KamilWuu/Stefan/README.md

# Stefan

### minisumo robot
### test gita czy cos
## git na windowsie
vscode
