KamilWuu/Stefan/docs/tytulowa.tex

\begin{titlepage} %crea l'enviroment
\begin{figure}[t] %inserisce le figure
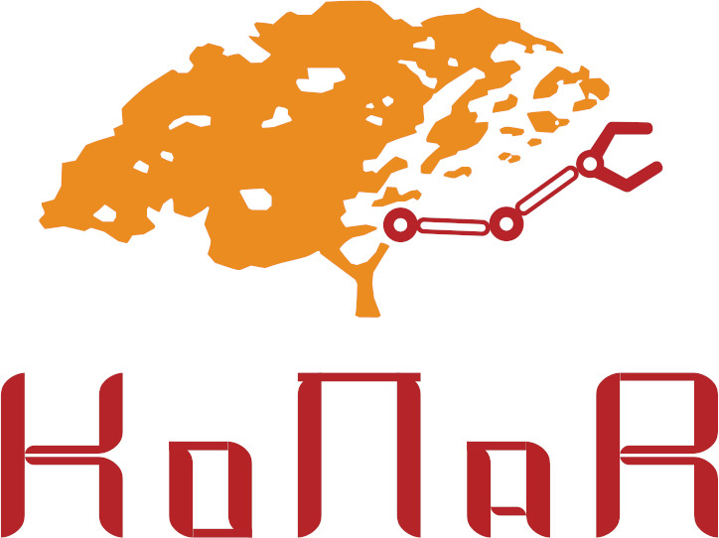
[picture p1: docs/photo_2/sprite_src_konar_vertical.jpg]
    \centering
\end{figure}
\vspace{20mm}

\begin{Large}
 \begin{center}
	\textbf{Koło naukowe robotyków KoNaR\\ Politechnika Wrocławska\\}
	\vspace{30mm}

            \hrule
            \vspace{10mm}
	{\huge{\bf Projekt robota mobilnego klasy minisumo "Stefan"}}
            \vspace{10mm}
            \hrule
\end{center}
\end{Large}

\vspace{36mm}
%minipage divide la pagina in due sezioni settabili
\begin{minipage}[t]{0.47\textwidth}
	
\end{minipage}
\hfill
\begin{minipage}[t]{0.47\textwidth}\raggedleft
	{\large{\bf Autor:\\ Kamil Winnicki}}
\end{minipage}

\vspace{25mm}

\hrulefill

\vspace{5mm}

\centering{\large{\bf Luty 2023 }}

\end{titlepage}
