KamilWuu/Stefan/docs/Opis robota ILYS_S.docx

1. Nazwa drużyny:

KoNaR_KW

2. Opis drużyny:

Jestem studentem 2 roku automatyki i robotyki na wydziale elektroniki, fotoniki i mikrosystemów na Politechnice Wrocławskiej. Od roku należe do koła naukowego robotyków KoNar.

3. Kamil należy do koła naukowego KoNaR z Politechniki Wrocławskiej. Jest ogromnym fanem robotyki. Robot klasy minisumo ILYT_S jest jego pierwszym robotem turniejowym.
4. Robot ILYT_S jest typowym robotem klasy minisumo. Napędzają go dwa silniki szczotkowe z przekładnią 1:30. Posiada aluminiową obudowę oraz konstrukcje wykonaną za pomocą technologii druku 3D. Strona elektroniczna opiera się na mikrokontrolerze Arduino NANO, sterowniku silników TB6612, dwóch odbiciowych czujników CNY70 wykorzystanych do detekcji koloru podłoża, oraz dwóch czujników odległości SHARP. Do zasilania została wykorzystana bateria Li – Pol 2S 7,4V oraz zastosowany został zewnętrzny stabilizator napięcia co jest dodatkowym zabezpieczniem przed przepaleniem stabilizatora wbudowanego do płytki Arduino. Program robota został napisany w środowisku Arduino. W najbliższym czasie planowana jest rozbudowa robota o „wachlarze” pozwalające na ciekawe taktyki walki. Robot ma szczegolną osobowość na co wskazuje jego niezwykły wyraz twarzy.

; )

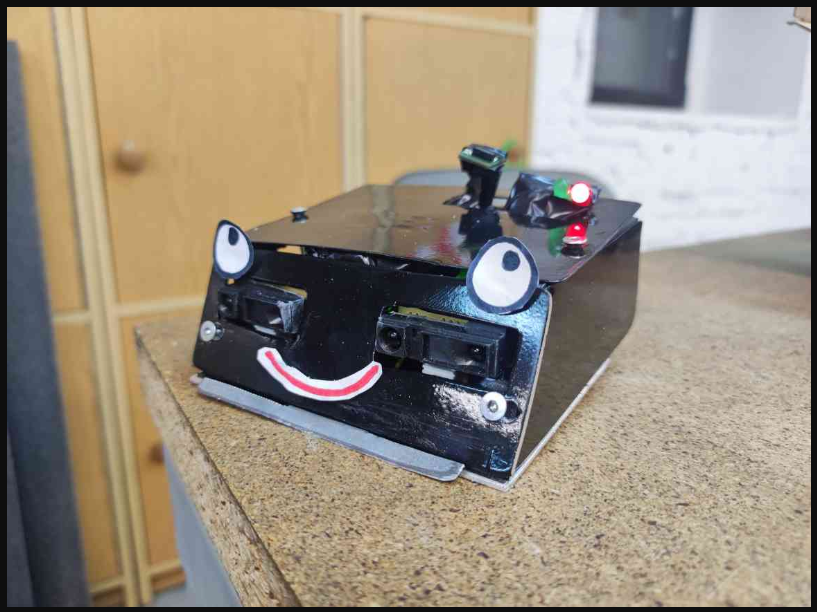
[picture p2: figure]
