KamilWuu/Stefan/docs/photo/Schemat_rozmieszczenia.jpg

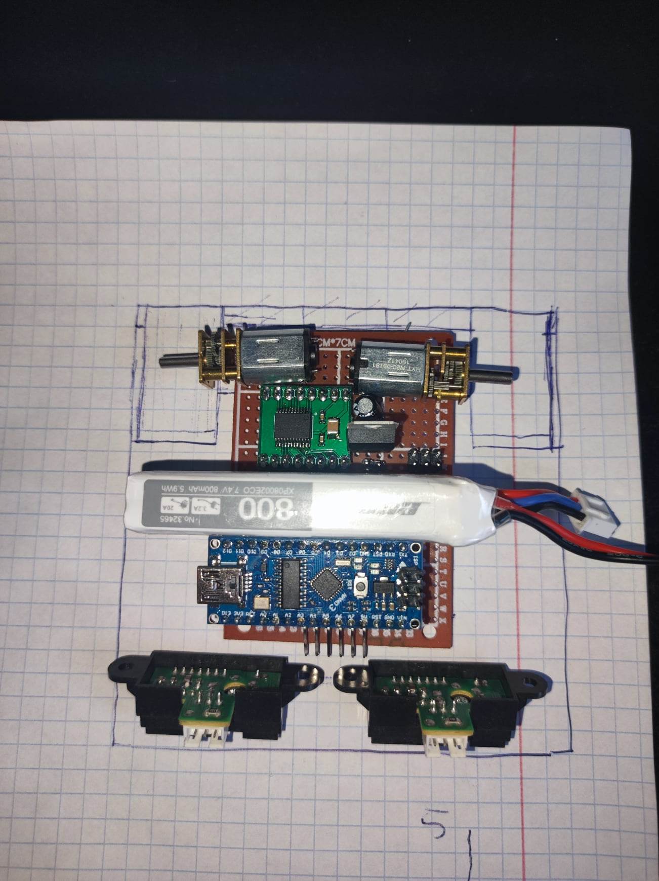
docs/photo/Schemat_rozmieszczenia.jpg
