KamilWuu/Stefan/docs/photo/Stabiliozator.jpg

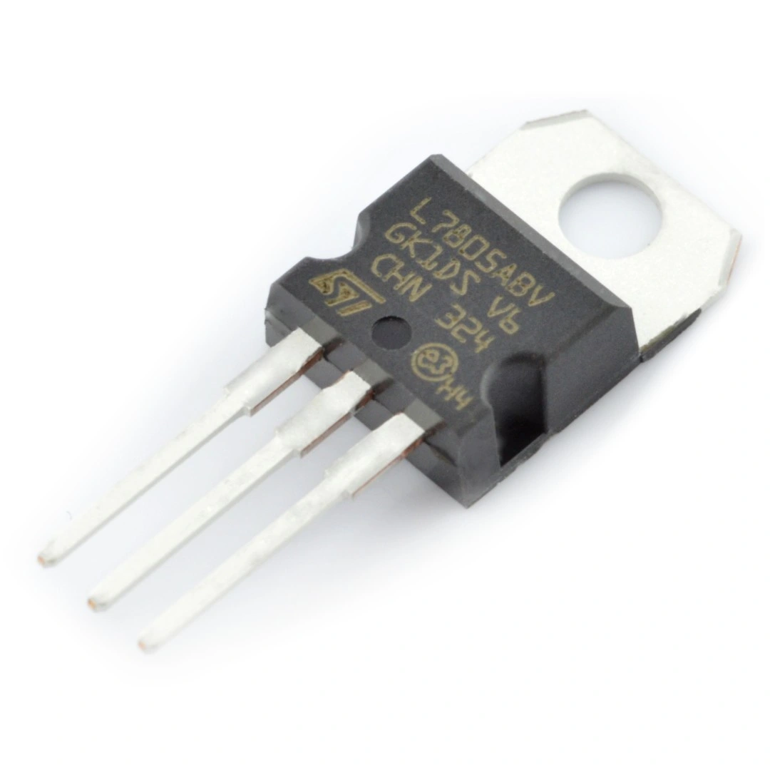
docs/photo/Stabiliozator.jpg
