KamilWuu/Stefan/docs/photo_2/330680536_1497188300806785_8608517706660153120_n.jpg

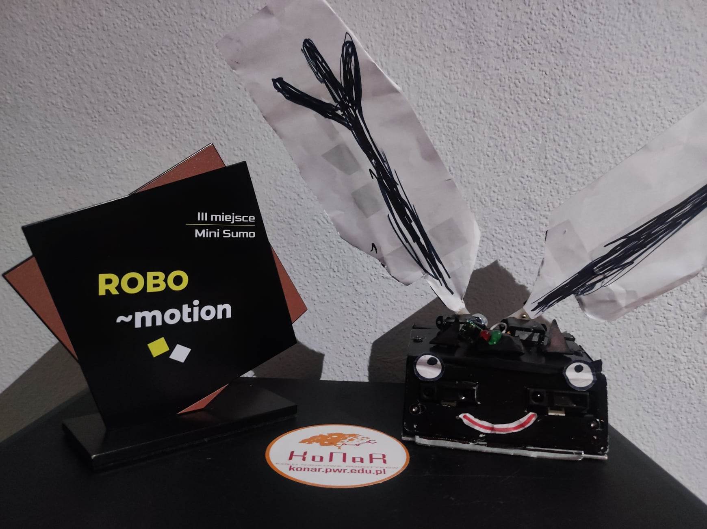
docs/photo_2/330680536_1497188300806785_8608517706660153120_n.jpg
