KamilWuu/Stefan/docs/photo_2/StefanBukareszt1.png

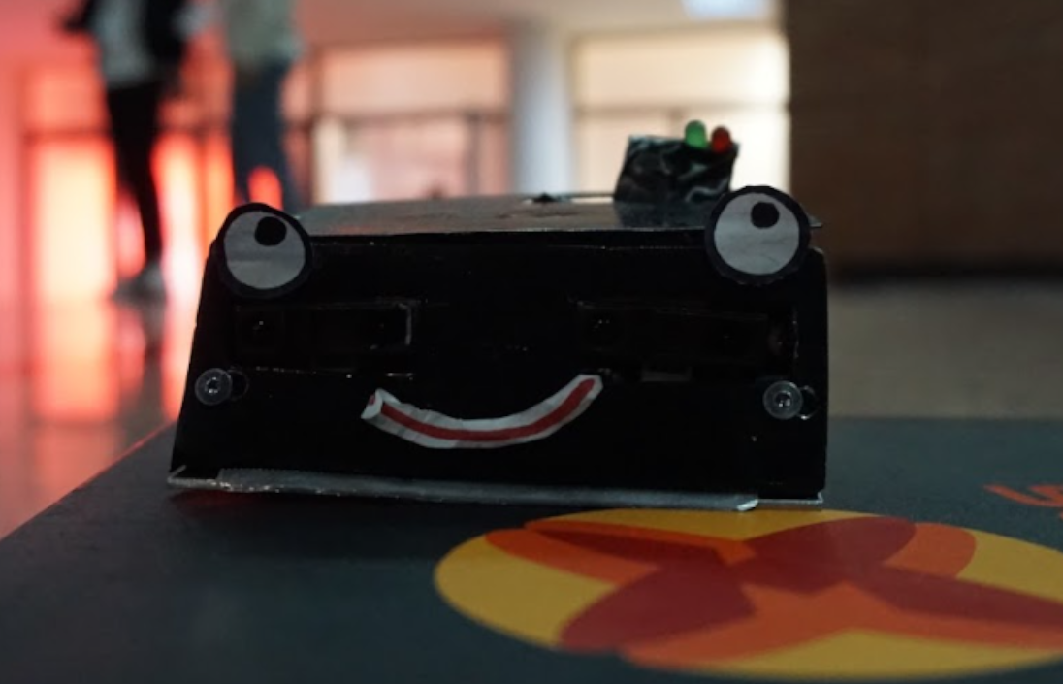
docs/photo_2/StefanBukareszt1.png
