KamilWuu/Stefan/docs/photo_2/Stefann.png

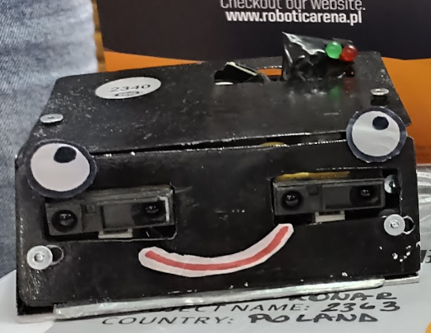
docs/photo_2/Stefann.png
