KamilWuu/Stefan/docs/photo_2/StefanZPolski.png

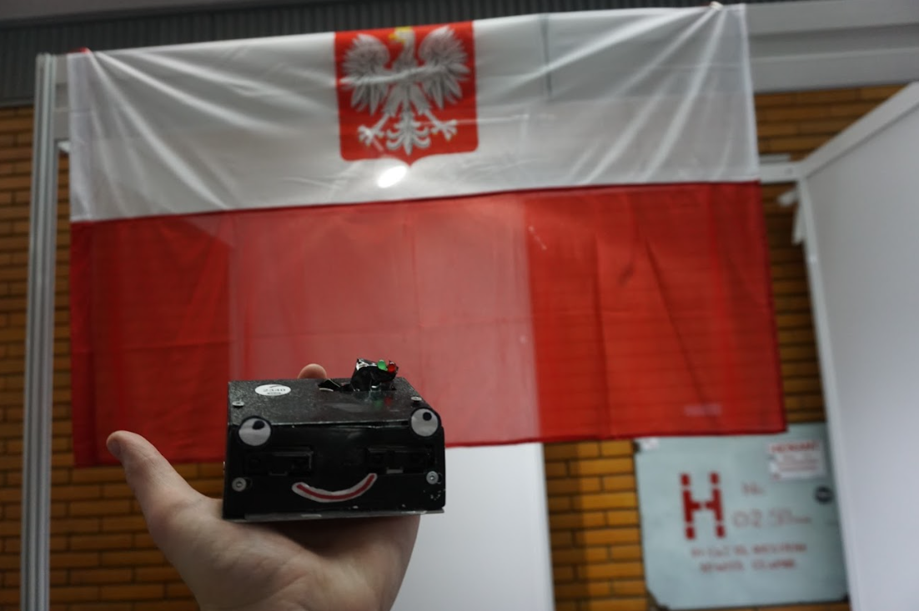
docs/photo_2/StefanZPolski.png
