KamilWuu/Stefan/docs/Scheme/caly.jpg

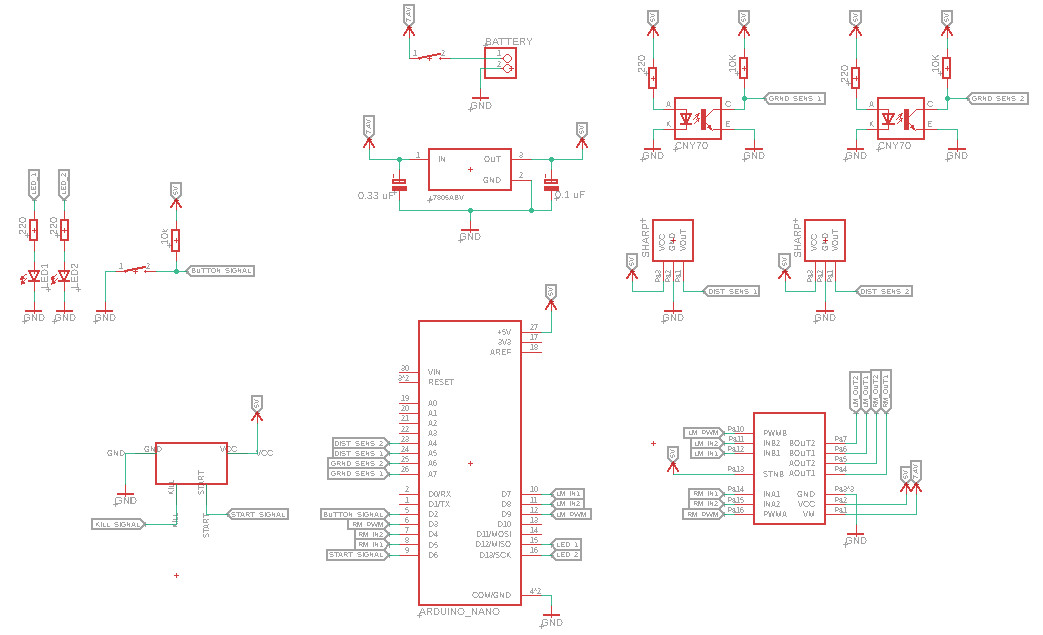
docs/Scheme/caly.jpg
