KamilWuu/Stefan/Zrzut ekranu 2023-07-08 150453.png

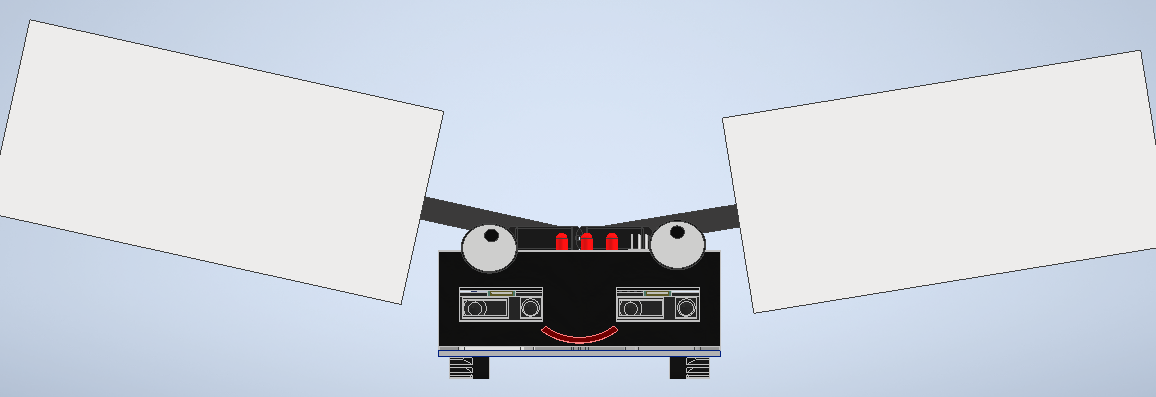
Zrzut ekranu 2023-07-08 150453.png
