KamilWuu/Stefan/mechanics_v2/dol.stl

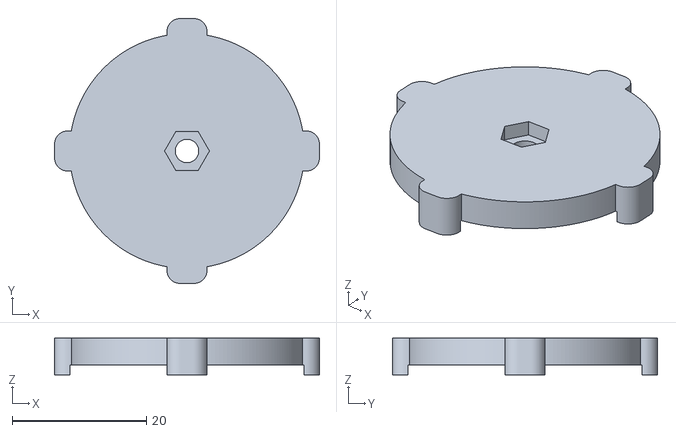
[picture p43: CAD file, 2024-05-01]
mechanics_v2/dol.stl
39.5 x 39.5 x 5.50
