KamilWuu/Stefan/mechanics_v2/board_up.stp

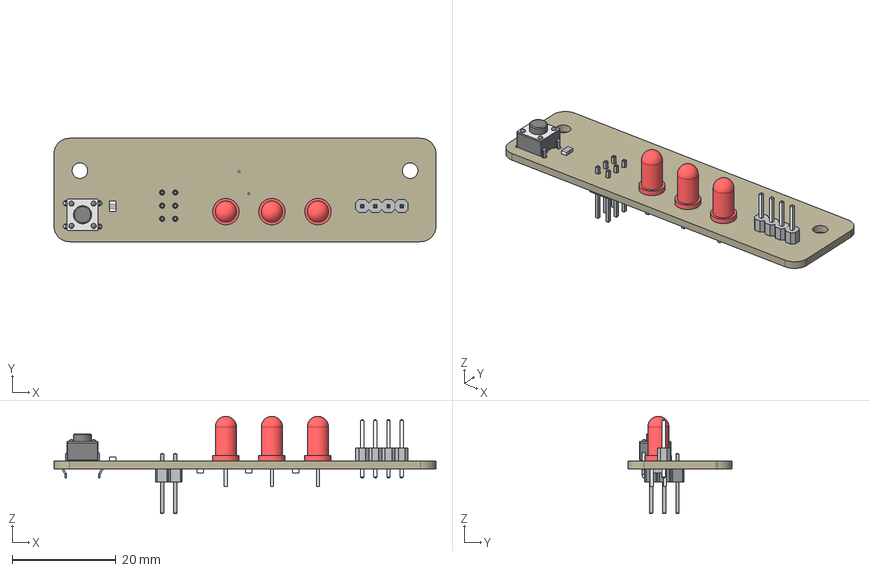
[picture p44: CAD file, 2023-07-09]
mechanics_v2/board_up.stp
73.8 x 20.0 x 18.8 mm
Board
LED5MM x 3
2X03
R0805 x 4
1X03 x 2
TS6-THT_H-5.0
