KamilWuu/Stefan/mechanics/uchwyt_na_silnik.stp

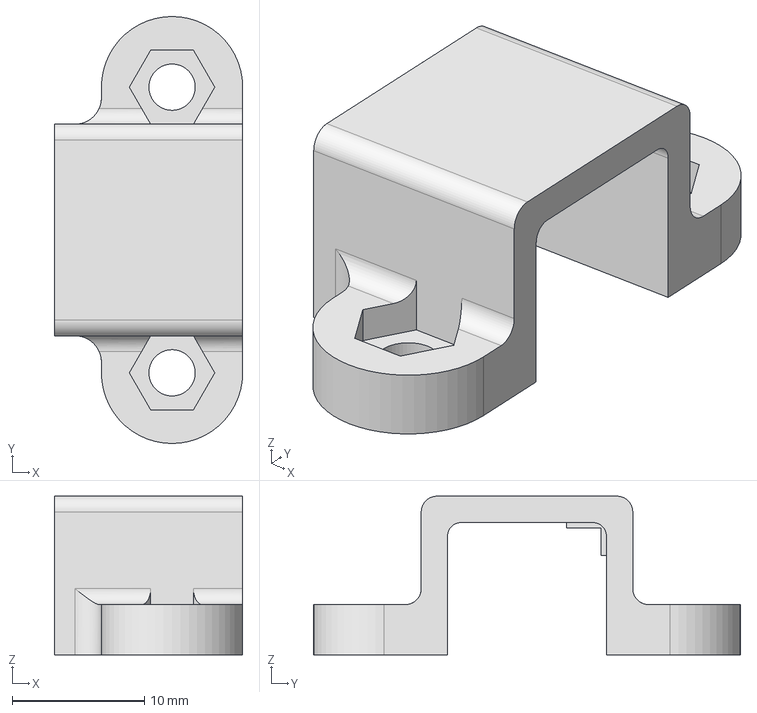
[picture p45: CAD file, 2023-05-13, an earlier design]
mechanics/uchwyt_na_silnik.stp
14.2 x 32.3 x 12.0 mm
