KamilWuu/Stefan/(list of files, cad)

Other CAD files:
mechanics/FORMA.iam
mechanics/KÓŁKO_STEFAN.ipt
mechanics/KÓŁKO_STEFAN_NOWE.ipt
mechanics/KÓŁKO_STEFAN_NOWE_DO_FORMY.ipt
mechanics/OldVersions/PCB.0005.ipt
mechanics/OldVersions/PCBE_2_2.0002.ipt
mechanics/OldVersions/PCB_DOLNE+GORNE.0002.ipt
mechanics/OldVersions/SCIANA_2.0.0002.ipt
mechanics/OldVersions/SCIANA_2.0_MIR.0004.ipt
mechanics/OldVersions/STEFAN_2.0.0007.iam
mechanics/OldVersions/STEFAN_PRE_2.0 — kopia.0010.iam
mechanics/OldVersions/Zespół1.0001.iam
mechanics/OldVersions/koło_minisumo.0001.ipt
mechanics/OldVersions/minisumopodsr.0005.ipt
mechanics/OldVersions/mocowanie_serw.0004.ipt
mechanics/OldVersions/n20 motor.0001.ipt
mechanics/OldVersions/pokrywa lewa.0002.ipt
mechanics/OldVersions/pokrywa prawa.0004.ipt
mechanics/OldVersions/pokrywa.0003.ipt
mechanics/OldVersions/pokrywka.0001.ipt
mechanics/OldVersions/pług_v2.0002.ipt
mechanics/OldVersions/sciana PRE 2.0.0006.ipt
mechanics/OldVersions/sciana PRE 2.0_MIR1.0001.ipt
mechanics/OldVersions/sciana_lewa_v5.0003.ipt
mechanics/OldVersions/sciana_prawa_v4.0008.ipt
mechanics/OldVersions/servo_stefan.0001.ipt
mechanics/OldVersions/uchwyt_na_silnik.0001.ipt
mechanics/OldVersions/uchwyt_nowy.0001.ipt
mechanics/OldVersions/zlozenie.0009.iam
mechanics/SCIANA_2.0.ipt
mechanics/SCIANA_2.0_MIR.ipt
mechanics/SCIANA_2.0_MIR_MIR.ipt
mechanics/STEFAN_2.0.iam
mechanics/STEFAN_PRE_2.0 — kopia.iam
mechanics/TOF_VLCOS.ipt
mechanics/Zespół1.iam
mechanics/bateria szczurza.ipt
mechanics/koło.ipt
mechanics/microservo SG90.ipt
mechanics/microservo SG90_MIR.ipt
mechanics/minisumopodsr.ipt
mechanics/mocowanie_serw.ipt
mechanics/opona_nowa.ipt
mechanics/pokrywa lewa.ipt
mechanics/pokrywa prawa.ipt
mechanics/pokrywa.ipt
mechanics/pokrywka.ipt
mechanics/pług.ipt
mechanics/pług_v2.ipt
mechanics/sciana PRE 2.0.ipt
mechanics/sciana PRE 2.0_MIR.ipt
mechanics/sciana PRE 2.0_MIR1.ipt
mechanics/sciana PRE 2.0_MIR2.ipt
mechanics/sciana_lewa_v4.ipt
mechanics/sciana_lewa_v5.ipt
mechanics/sciana_prawa_v4.ipt
mechanics/servo_stefan.ipt
mechanics/servo_stefan_MIR.ipt
mechanics/uchwyt_na_silnik.ipt
mechanics/uchwytlewy.ipt
mechanics/uchwytprawy.ipt
mechanics/zlozenie.iam
mechanics_v2/1X02.ipt
mechanics_v2/1X03.ipt
mechanics_v2/2X03.ipt
mechanics_v2/Board_1.ipt
mechanics_v2/Board_2.ipt
mechanics_v2/GP2Y0A41SK0F.ipt
mechanics_v2/LED5MM.ipt
mechanics_v2/OldVersions/1X02.0001.ipt
mechanics_v2/OldVersions/SCIANA_LEWA_NOWA_2.0002.ipt
mechanics_v2/OldVersions/SCIANA_PRAWA_NOWA_2.0001.ipt
mechanics_v2/OldVersions/STEFAN.0029.iam
mechanics_v2/OldVersions/dach.0007.ipt
mechanics_v2/OldVersions/dol.0001.ipt
mechanics_v2/OldVersions/gora.0002.ipt
mechanics_v2/OldVersions/kolo.0002.ipt
mechanics_v2/OldVersions/minisumopodsr.0006.ipt
mechanics_v2/OldVersions/mocowanie sharpow.0015.ipt
mechanics_v2/OldVersions/oko.0001.ipt
mechanics_v2/OldVersions/opona.0003.ipt
mechanics_v2/OldVersions/ploter_1.0001.iam
mechanics_v2/OldVersions/ploter_1_SUB.0001.ipt
mechanics_v2/OldVersions/plug_2.0010.ipt
mechanics_v2/OldVersions/plug_kopia.0004.ipt
mechanics_v2/OldVersions/plug_nowy.0003.ipt
mechanics_v2/OldVersions/plytka_dol.0001.iam
mechanics_v2/OldVersions/podstawa.0008.ipt
mechanics_v2/OldVersions/pokrywa lewa.0004.ipt
mechanics_v2/OldVersions/pokrywa prawa.0006.ipt
mechanics_v2/OldVersions/pokrywa tylna.0002.ipt
mechanics_v2/OldVersions/reka.0002.ipt
mechanics_v2/OldVersions/sciana_prawa_nowa.0011.ipt
mechanics_v2/OldVersions/sciana_prawa_nowa_MIR.0004.ipt
mechanics_v2/OldVersions/servo_mini_1370hd_cos.0001.ipt
mechanics_v2/OldVersions/tyl.0003.ipt
mechanics_v2/OldVersions/tylna.0003.ipt
mechanics_v2/OldVersions/uchwyt_nowy.0002.ipt
mechanics_v2/OldVersions/uchwyt_serw.0001.ipt
mechanics_v2/OldVersions/uchwyt_silnikow.0002.ipt
mechanics_v2/OldVersions/wlacznik_2.0001.ipt
mechanics_v2/OldVersions/zaslepka.0002.ipt
mechanics_v2/SCIANA_LEWA_NOWA_2.ipt
mechanics_v2/SCIANA_PRAWA_NOWA_2.ipt
mechanics_v2/STEFAN.iam
mechanics_v2/TO220V.ipt
mechanics_v2/Zespół4.iam
mechanics_v2/blokada.ipt
mechanics_v2/board_up.ipt
mechanics_v2/buzia.ipt
mechanics_v2/dach.ipt
mechanics_v2/dociazenie.ipt
mechanics_v2/dol.ipt
mechanics_v2/forma.iam
mechanics_v2/gora.ipt
mechanics_v2/jakas awaryjna.ipt
mechanics_v2/kolo.ipt
mechanics_v2/kopia_plug.ipt
mechanics_v2/koło_minisumo.ipt
mechanics_v2/mocowanie sharpow.ipt
mechanics_v2/motor drive module TB6612.ipt
mechanics_v2/n20 motor.ipt
mechanics_v2/oko.ipt
mechanics_v2/opona.ipt
mechanics_v2/ploter_1.iam
mechanics_v2/ploter_1_SUB.ipt
mechanics_v2/plug_2.ipt
mechanics_v2/plug_kopia.ipt
mechanics_v2/plug_nowy.ipt
mechanics_v2/plytka_dol.iam
mechanics_v2/podstawa.ipt
mechanics_v2/podstawa_formy.ipt
mechanics_v2/pokrywa lewa.ipt
mechanics_v2/pokrywa prawa.ipt
mechanics_v2/pokrywa tylna.ipt
mechanics_v2/reka.ipt
mechanics_v2/sciana_lewa_NOWA.ipt
mechanics_v2/sciana_prawa_nowa.ipt
mechanics_v2/sciana_prawa_nowa_MIR.ipt
mechanics_v2/servo_mini_1370hd_cos.ipt
mechanics_v2/szkic.ipt
mechanics_v2/testowa.ipt
mechanics_v2/tyl.ipt
mechanics_v2/tylna.ipt
mechanics_v2/uchwyt_nowy.ipt
mechanics_v2/uchwyt_serw.ipt
mechanics_v2/uchwyt_silnikow.ipt
mechanics_v2/wlacznik.ipt
mechanics_v2/wlacznik_2.ipt
mechanics_v2/zaslepka.ipt
