KamilWuu/Stefan/(list of files, drawings)

Other design files:
electronics/MINISUMO final.fzz
electronics/minisumo kopia.fzz
electronics/minisumo LLSR.fzz
electronics/minisumo v2.fzz
electronics/sensor board.fzz
