KamilWuu/Stefan/electronics_v2/Stefan 2.0.brd

## EAGLE design electronics_v2/Stefan 2.0.brd (2024-05-01)

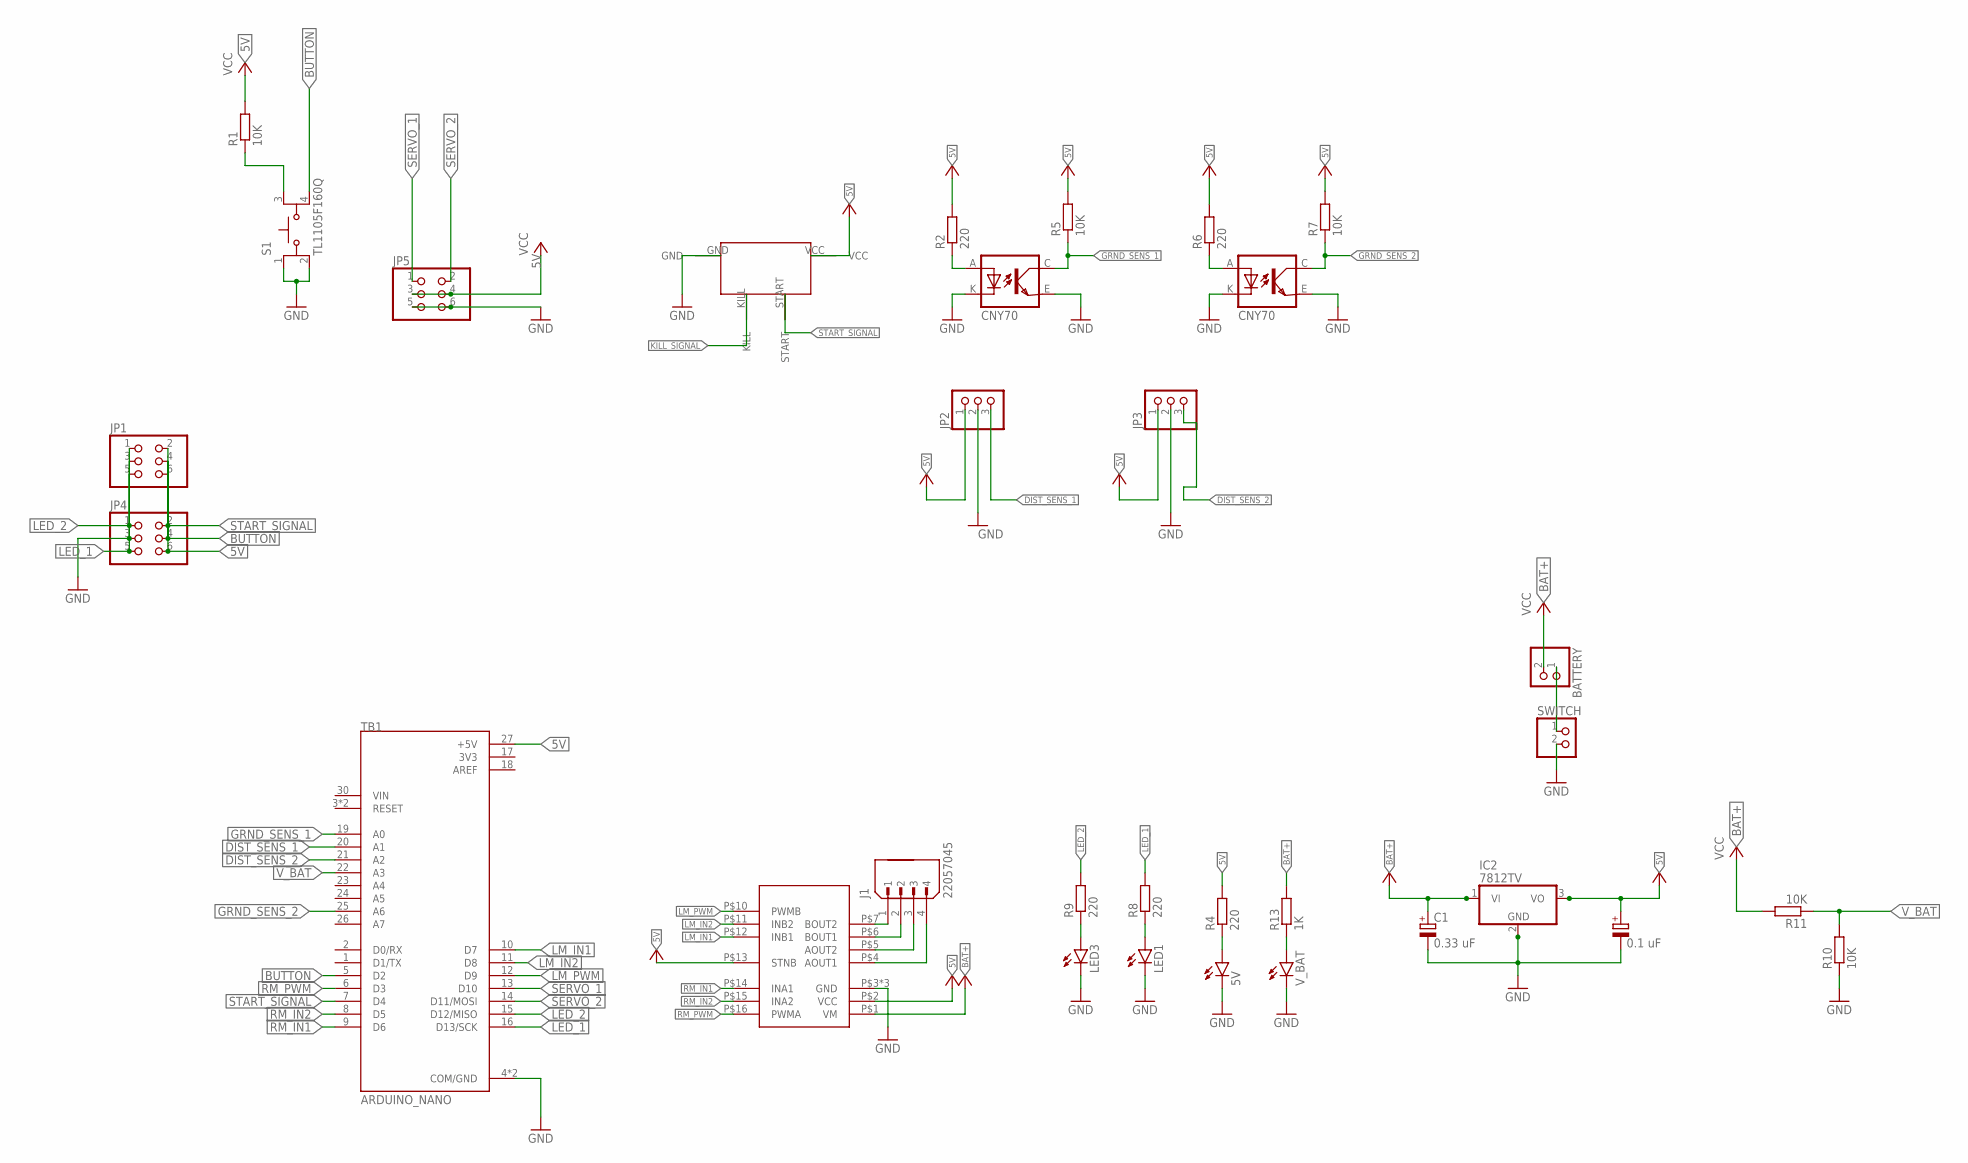
[picture p46: schematic Stefan 2.0.sch, sheet 1]

Parts:
5V: LED5MM
BATTERY: PINHD-1X2; 1X02
C1: 0.33 uF; TAP5-70
C2: 0.1 uF; SANYO-OSCON_A
IC2: 7812TV; TO220V
J1: 22057045; MOLEX_22057045
JP1, JP4, JP5: PINHD-2X3; 2X03
JP2, JP3: PINHD-1X3; 1X03
LED1, LED3: LED5MM
R1, R5, R7, R10, R11: 10K; R0805
R2, R4, R6, R8, R9: 220; R0805
R13: 1K; R0805
S1: TL1105F160Q; SW_TL1105F160Q
SUMO_START_MODULE1: SUMO_START_MODULE
SWITCH: PINHD-1X2; 1X02
TB1: ARDUINO_NANO; SHIELD_ARDUINO_NANO
TB2: TB6612MODULE
U$2, U$4: CNY70; 4
V_BAT: LEDCHIPLED_1206; CHIPLED_1206

Connections:
3V3: TB1.17 (3V3)
5V: C2.+, IC2.3 (VO), JP1.6, JP2.1, JP3.1, JP4.6, JP5.3, JP5.4, R1.2, R2.2, R4.2, R5.2, R6.2, R7.2, SUMO_START_MODULE1.VCC, TB1.27 (+5V), TB2.P$2 (VCC), TB2.P$13 (STNB)
AREF: TB1.18 (AREF)
BAT+: BATTERY.2, C1.+, IC2.1 (VI), R11.2, R13.2, TB2.P$1 (VM)
BUTTON: JP1.4, JP4.4, S1.4, TB1.5 (D2)
DIST_SENS_1: JP2.3, TB1.20 (A1)
DIST_SENS_2: JP3.3, TB1.21 (A2)
GND: 5V.K (C), C1.-, C2.-, IC2.2 (GND), JP1.3, JP2.2, JP3.2, JP4.3, JP5.5, JP5.6, LED1.K (C), LED3.K (C), R10.1, S1.1, S1.2, SUMO_START_MODULE1.GND, SWITCH.2, TB1.4 (COM/GND), TB1.29 (COM/GND), TB2.P$3 (GND), TB2.P$8 (GND), TB2.P$9 (GND), U$2.E (EMI), U$2.K (C), U$4.E (EMI), U$4.K (C), V_BAT.C
GRND_SENS_1: R5.1, TB1.19 (A0), U$2.C (COL)
GRND_SENS_2: R7.1, TB1.25 (A6), U$4.C (COL)
KILL_SIGNAL: SUMO_START_MODULE1.KILL
LED_1: JP1.5, JP4.5, R8.2, TB1.16 (D13/SCK)
LED_2: JP1.1, JP4.1, R9.2, TB1.15 (D12/MISO)
LM_IN1: TB1.10 (D7), TB2.P$12 (INB1)
LM_IN2: TB1.11 (D8), TB2.P$11 (INB2)
LM_OUT1: J1.2, TB2.P$6 (BOUT1)
LM_OUT2: J1.1, TB2.P$7 (BOUT2)
LM_PWM: TB1.12 (D9), TB2.P$10 (PWMB)
unnamed: BATTERY.1, SWITCH.1
unnamed: LED3.A, R9.1
unnamed: R2.1, U$2.A
unnamed: R6.1, U$4.A
unnamed: LED1.A, R8.1
unnamed: 5V.A, R4.1
unnamed: R13.1, V_BAT.A
unnamed: R1.1, S1.3
RM_IN1: TB1.9 (D6), TB2.P$14 (INA1)
RM_IN2: TB1.8 (D5), TB2.P$15 (INA2)
RM_OUT1: J1.4, TB2.P$4 (AOUT1)
RM_OUT2: J1.3, TB2.P$5 (AOUT2)
RM_PWM: TB1.6 (D3), TB2.P$16 (PWMA)
SERVO_1: JP5.1, TB1.13 (D10)
SERVO_2: JP5.2, TB1.14 (D11/MOSI)
START_SIGNAL: JP1.2, JP4.2, SUMO_START_MODULE1.START, TB1.7 (D4)
V_BAT: R10.2, R11.1, TB1.22 (A3)

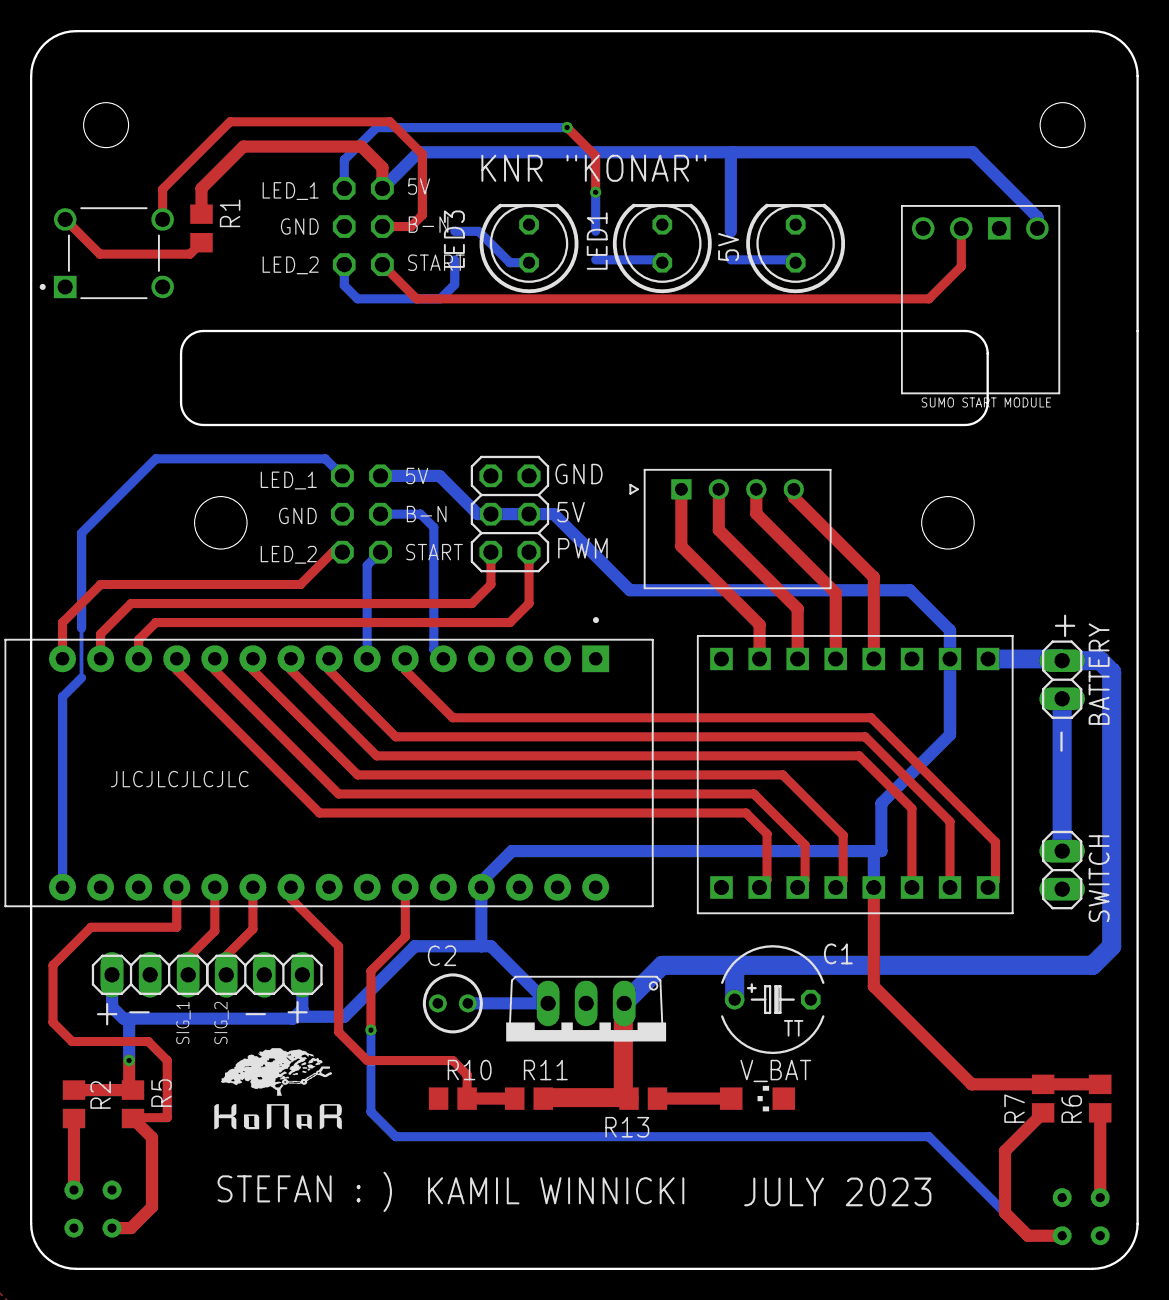
[picture p47: board Stefan 2.0.brd from above]

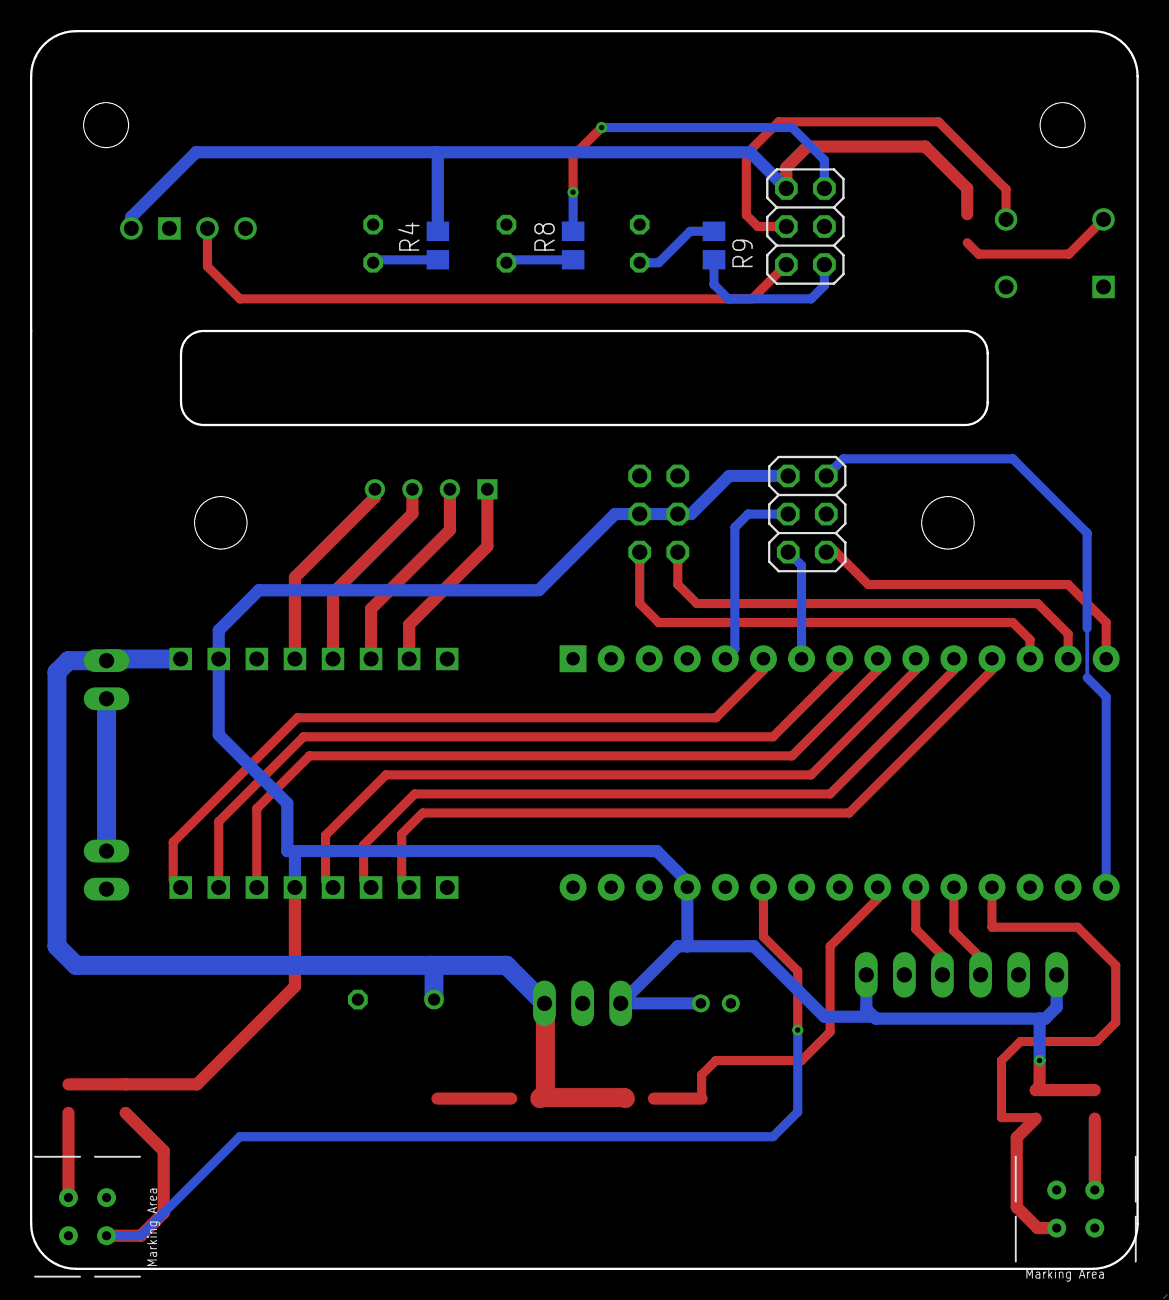
[picture p48: board Stefan 2.0.brd from below]

Board: 2 copper layers, 73.8 x 82.6 mm, 32 parts (7 on the bottom side), 32 nets.
