KamilWuu/Stefan/electronics/Stefan2/Stefan2.brd

## EAGLE design electronics/Stefan2/Stefan2.brd (2023-02-24, an earlier design)

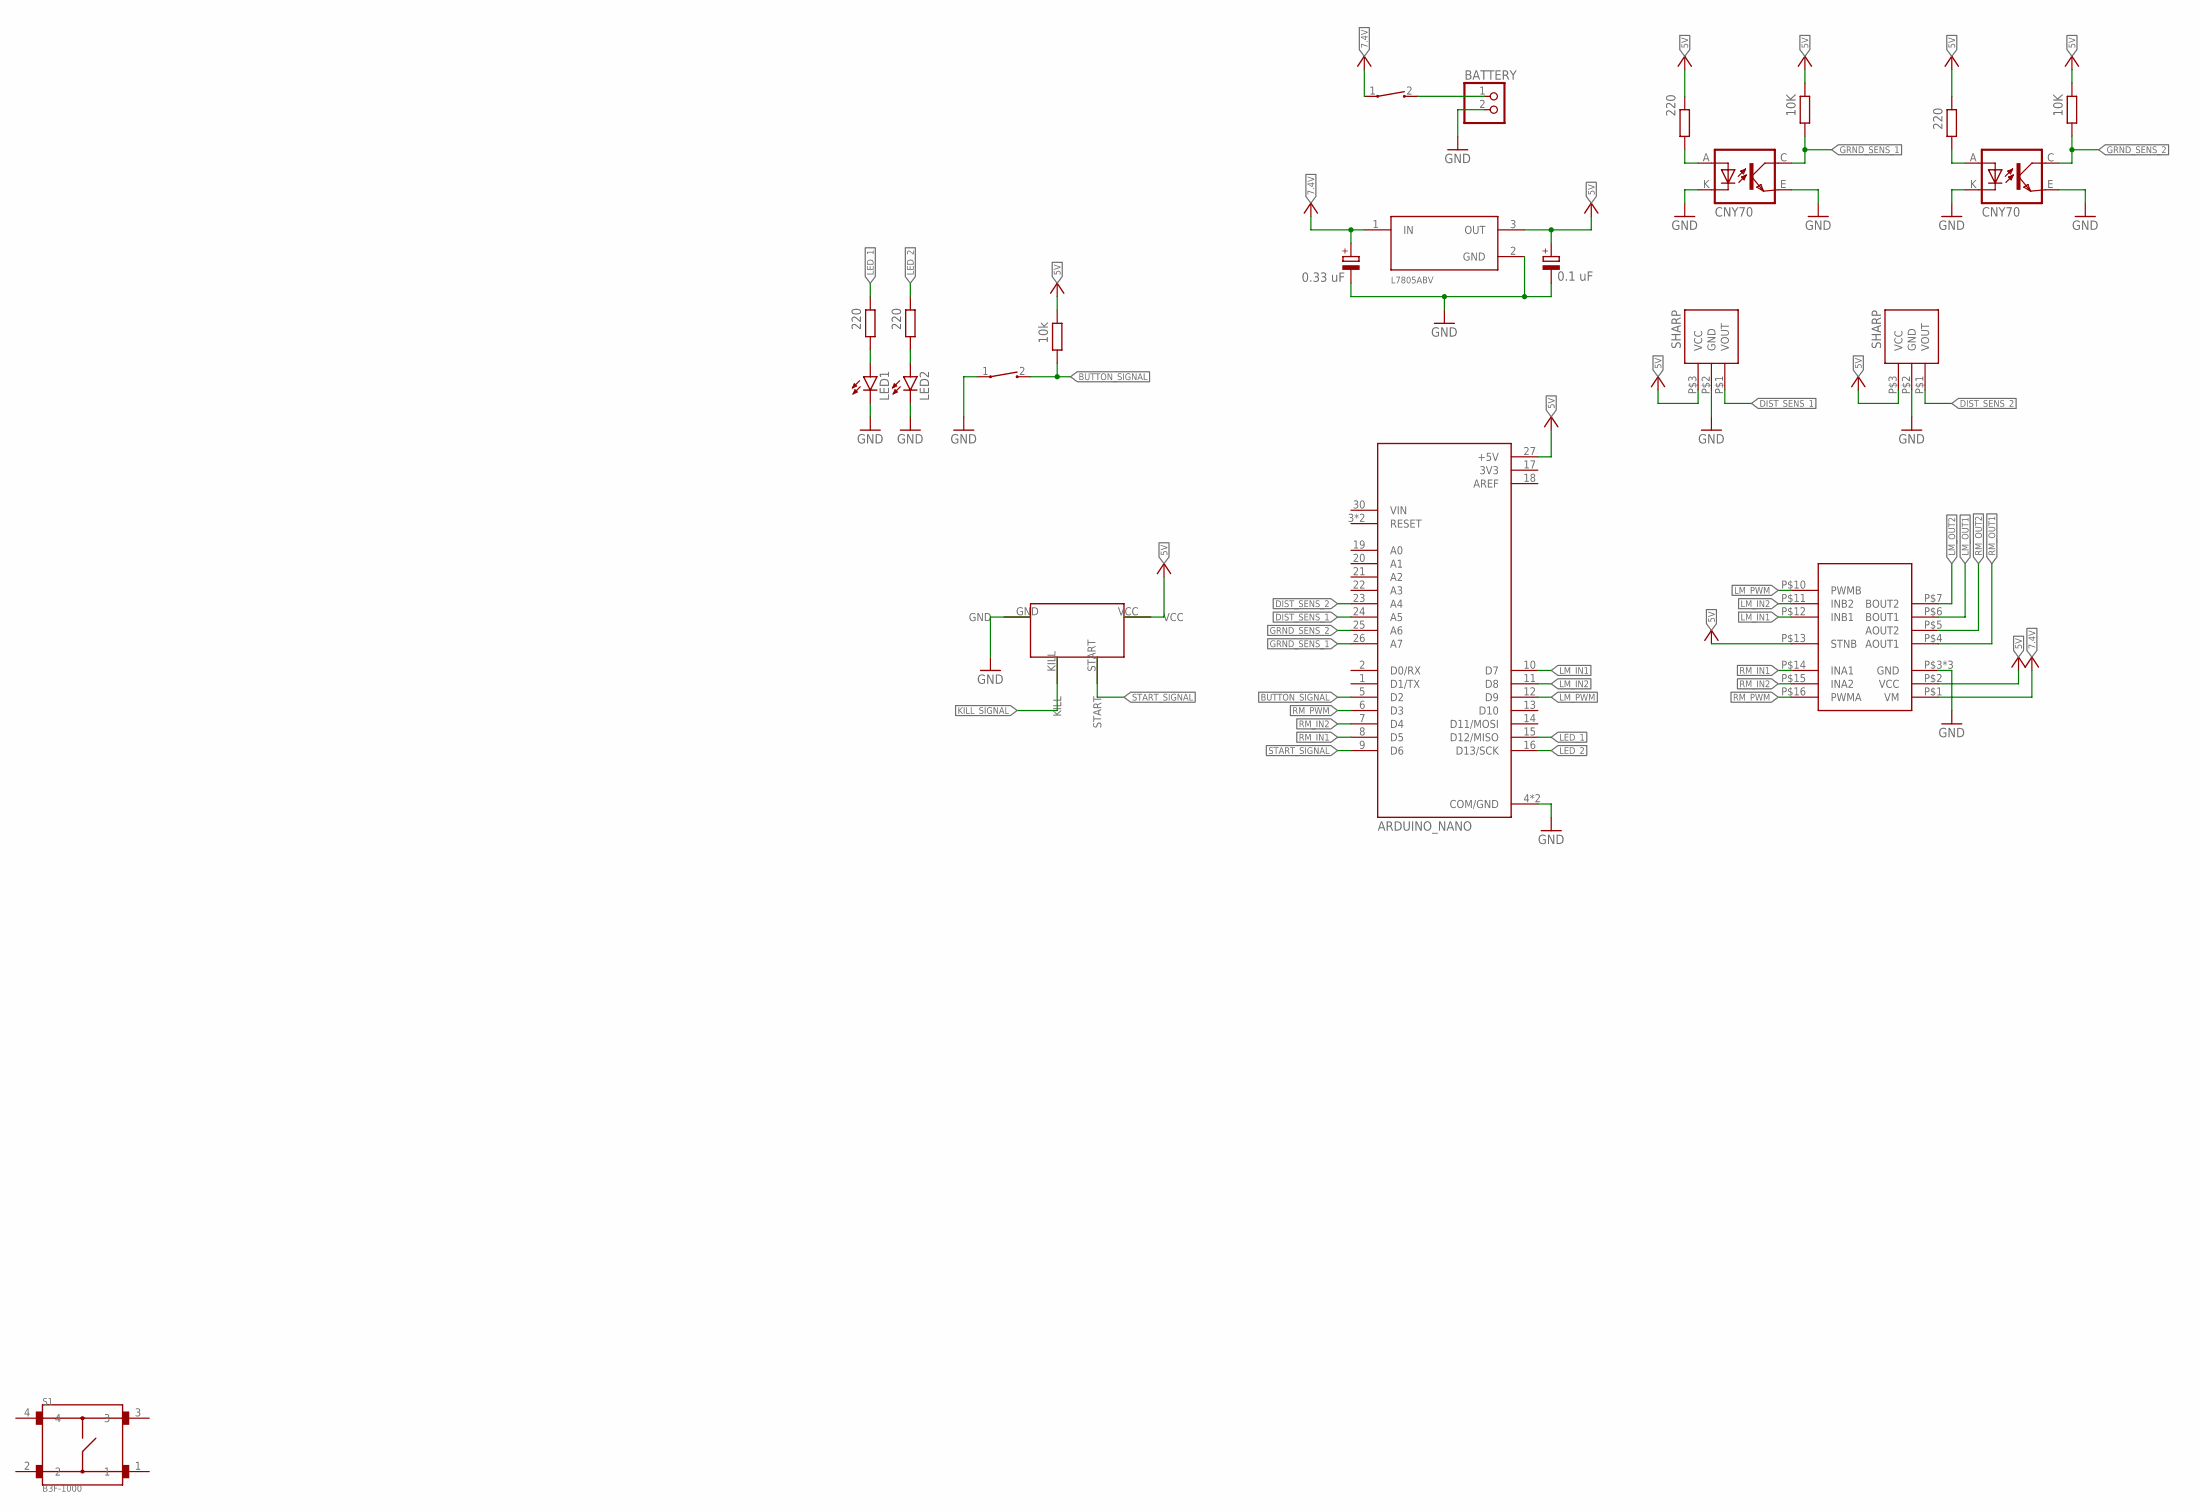
[picture p49: schematic Stefan2.sch]

Parts:
BATTERY: PINHD-1X2; 1X02
C1: 0.33 uF; SANYO-OSCON_A
C2: 0.1 uF; SANYO-OSCON_A
LED1, LED2: LED5MM
R1, R4, R6, R7: 220; 0207/10
R3, R8: 10K; 0207/10
R5: 10k; 0207/10
S1: B3F-1000; SW_B3F-1000
SUMO_START_MODULE: SUMO_START_MODULE
SW1, SW2: 147873-1; SW_147873-1
TB1: ARDUINO_NANO; SHIELD_ARDUINO_NANO
TB6612: TB6612MODULE
U1, U3: SHARP; GP2DXX
U2: L7805ABV; TO254P460X1020X1945-3P
U$1, U$3: CNY70; 4

Connections:
3V3: TB1.17 (3V3)
5V: C2.+, R1.2, R3.2, R5.2, R7.2, R8.2, SUMO_START_MODULE.VCC, TB1.27 (+5V), TB6612.P$2 (VCC), TB6612.P$13 (STNB), U1.P$3 (VCC), U2.3 (OUT), U3.P$3 (VCC)
7.4V: C1.+, SW2.1, TB6612.P$1 (VM), U2.1 (IN)
AREF: TB1.18 (AREF)
BUTTON_SIGNAL: R5.1, SW1.2, TB1.5 (D2)
DIST_SENS_1: TB1.24 (A5), U1.P$1 (VOUT)
DIST_SENS_2: TB1.23 (A4), U3.P$1 (VOUT)
GND: BATTERY.2, C1.-, C2.-, LED1.K (C), LED2.K (C), SUMO_START_MODULE.GND, SW1.1, TB1.4 (COM/GND), TB1.29 (COM/GND), TB6612.P$3 (GND), TB6612.P$8 (GND), TB6612.P$9 (GND), U2.2 (GND), U$1.E (EMI), U$1.K (C), U$3.E (EMI), U$3.K (C)
GRND_SENS_1: R3.1, TB1.26 (A7), U$3.C (COL)
GRND_SENS_2: R8.1, TB1.25 (A6), U$1.C (COL)
KILL_SIGNAL: SUMO_START_MODULE.KILL
LED_1: R4.2, TB1.15 (D12/MISO)
LED_2: R6.2, TB1.16 (D13/SCK)
LM_IN1: TB1.10 (D7), TB6612.P$12 (INB1)
LM_IN2: TB1.11 (D8), TB6612.P$11 (INB2)
LM_OUT1: TB6612.P$6 (BOUT1)
LM_OUT2: TB6612.P$7 (BOUT2)
LM_PWM: TB1.12 (D9), TB6612.P$10 (PWMB)
unnamed: LED1.A, R4.1
unnamed: LED2.A, R6.1
unnamed: R1.1, U$3.A
unnamed: R7.1, U$1.A
unnamed: BATTERY.1, SW2.2
unnamed: U1.P$2 (GND), U3.P$2 (GND)
RM_IN1: TB1.8 (D5), TB6612.P$14 (INA1)
RM_IN2: TB1.7 (D4), TB6612.P$15 (INA2)
RM_OUT1: TB6612.P$4 (AOUT1)
RM_OUT2: TB6612.P$5 (AOUT2)
RM_PWM: TB1.6 (D3), TB6612.P$16 (PWMA)
START_SIGNAL: SUMO_START_MODULE.START, TB1.9 (D6)

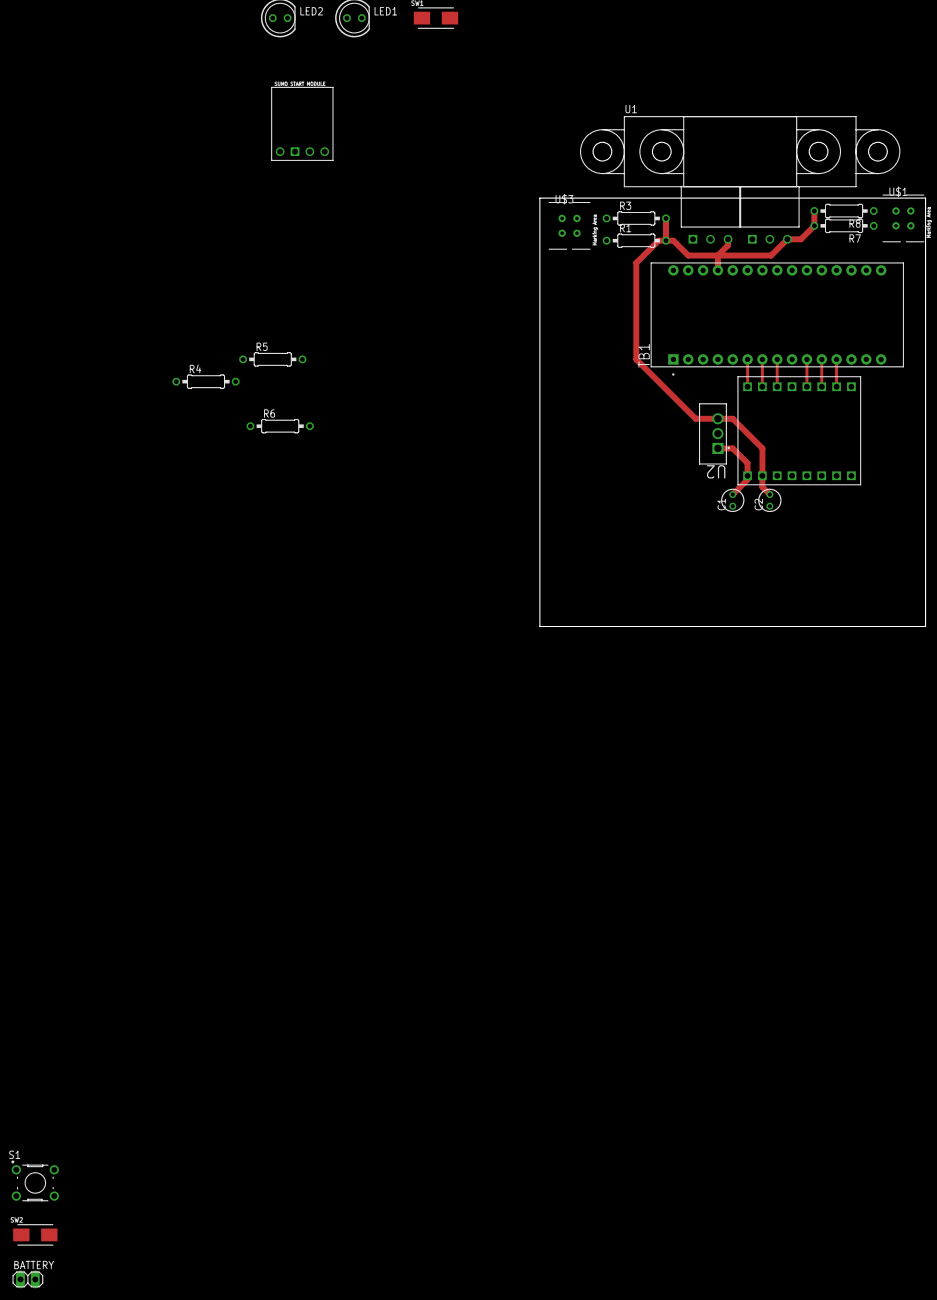
[picture p50: board Stefan2.brd from above]

Board: 2 copper layers, 66.0 x 73.3 mm, 23 parts (0 on the bottom side), 23 nets.
