KamilWuu/Stefan/(commit log)

2022-11-07 dodano schemat elektroniki
    [MINISUMO final.fzz, minisumo LLSR.fzz, minisumo kopia.fzz, minisumo v2.fzz, sensor board.fzz]
2023-02-24 uaktualniony kod oraz nowy pcb0.1
    [FORMA.iam, KÓŁKO_STEFAN.ipt, KÓŁKO_STEFAN_NOWE.ipt, KÓŁKO_STEFAN_NOWE_DO_FORMY.ipt, Stefan2.brd, Stefan2.sch, koło.ipt, sciana_lewa_v4.obj]
2023-05-13 kopia zapasowa przed zawodami we francji
    [ESP32 v2.ipt, GP2Y0A41SK0F.ipt, GP2Y0A41SK0F_MIR.ipt, GP2Y0A41SK0F_MIR1.ipt, PCB.0005.ipt, PCB.ipt, PCBE_2_2.0002.ipt, PCBE_2_2.ipt]
2023-07-09 zrobiono nowa mechanike i pcb
    [1X02.0001.ipt, 1X02.ipt, 1X03.ipt, 2X03.ipt, Board_1.ipt, Board_2.ipt, ESP32 v2.ipt, GP2Y0A41SK0F.ipt]
2024-05-01 mocno rpzedawniona aktualizacja repozytorium
    [1X02.0001.ipt, 1X02.ipt, 1X03.ipt, 2X03.ipt, Board_1.ipt, Board_2.ipt, GP2Y0A41SK0F.ipt, LED5MM.ipt]
